Jiherbe/Maeva/README.md

# Maeva
Base Domotique
Sources des programmes utilisés dans le projet domotique Maeva : Arduino, PHP, Mysql, Javascript.
CAO : Eagle. AGL : Netbeans
