Jiherbe/Maeva/Version 1.00/Documents/TeleInfo EDF.odt

Documentation de l'interface Datalogger TéléInfo

Version

1.10

Auteur

Jean-Roger BLOUIN

Date de dernière mise à jour : dimanche 12 février 2012

Historique du document

Date | Auteur | Version | Sujet de la modification
12/02/2012 | Jean-Roger BLOUIN | 1.10 | Création

# Présentation Générale.

## Le Contexte

Suite à la mise en place de panneaux solaires photovoltaïques pour revente totale de la production d'électricité, deux compteurs électriques supplémentaires ont été posés par ERDF :

- un compteur dit « d'injection » comptabilise la production
- un compteur de « non consommation » contrôle la revente totale de la production.

La consommation quotidienne est mesurée par le compteur d'abonné. Le suivi de la production et de la consommation impose un relevé périodique des compteurs et nécessite pour ce faire l'ouverture des coffrets situés en limite de propriété, extérieur pour le compteur de consommation, intérieur pour les deux autres.

## Objectifs.

Afin d'enregistrer les données émises par les 3 compteurs EDF, il est nécessaire de mettre en place un système qui permette le relevé de ces informations sans obligation d'accès aux coffrets extérieurs. Ce système devra idéalement enregistrer en permanence les données recueillies et permettre leur consultation en direct.

## Contraintes.

Le système de recueil de l'information sur les compteurs doit être indépendant et isolé du réseau EDF.

Les compteur seront surveillés l'un après l'autre de façon cyclique selon une périodicité ajustable. La surveillance simultanée fera l'objet d'une étude ultérieure.

Le système mis en place doit répondre aux spécifications et contraintes suivantes :

- Ne pas mobiliser un PC en permanence (économie d'énergie).
- Être autonome.
- Être interrogé à distance.
- Être configuré localement.
- Être de taille réduite.
- Faire largement appel aux ressources existantes.

## La Solution.

Un système d'enregistrement périodique des données (datalogger) a été retenu. Ce système offre les options suivantes :

a. l'enregistrement sur PC,
b. l'enregistrement de manière autonome sur carte SD,
c. l'envoi des donnée sur réseau Ethernet.

Ce système est basé sur une carte ARDUINO® associée à une ou plusieurs mezzanines selon les besoins.

# La Réalisation.

## Hardware.

## Software.

# Annexes.

# Références.

Parmi les nombreuses études similaires accessibles sur Internet, les liens suivant renvoient à celles qui ont plus spécifiquement inspirés cette réalisation.

- Documentation de l'interface Datalogger TéléInfo

Page 1 sur 11
