Jiherbe/Maeva/Version 1.00/Documents/TeleInfo Maeva1.odt

# Présentation Générale.

## Le Contexte

Suite à la mise en place de panneaux solaires photovoltaïques pour revente totale de la production d'électricité, deux compteurs électriques supplémentaires ont été posés par ERDF :

- un compteur dit « d'injection » comptabilise la production
- un compteur de « non consommation » contrôle la revente totale de la production.

La consommation quotidienne est mesurée par le compteur d'abonné. Le suivi de la production et de la consommation impose un relevé périodique des compteurs et nécessite pour ce faire l'ouverture des coffrets situés en limite de propriété, extérieur pour le compteur de consommation, intérieur pour les deux autre.

## Objectifs.

Télé-surveiller les 3 compteurs EDF :

- soutirage : compteur d'abonné triphasé avec heures creuses ;
- production : appelé aussi « injection », mesure l'énergie PV produite, monophasé sans HC ;
- non consommation : monophasé sans HC, sert à contrôler la revente totale de la production PV.

## La liaison Téléinfo.

(Source: [GESTIONNAIRE D'ÉNERGIE (http://bernard.lefrancois.free.fr/) ])

Les compteurs électroniques EDF possèdent deux bornes de télé information à disposition du client. Sur celles-ci, il est possible d'y lire des données informatiques sur la consommation électrique.

L'utilisation de ces bornes est, à l'origine, surtout destinée aux gestionnaires d’énergie disponibles dans le commerce. Mais il est aussi possible d'exploiter ces données sur un PC.

Les informations sont émises cycliquement sous forme de messages composés d’une étiquette d’identification suivie généralement d’une valeur.

Le signal est modulé à 50 KHz : la présence de modulation correspondant à un 0 logique, l’absence à un 1 logique. Il est donc nécessaire de démoduler ce signal. A l'issue, on obtient une suite de caractères ASCII émise à 1200 bits/s, 7 bits/caractères, parité paire, 1 bit de stop.

Chaque information débute par le caractère LF (0Ah), suivie de l’étiquette, de la valeur associée et se termine par le caractère CR (0Dh).

## Contraintes.

Le système de recueil de l'information sur les compteurs doit être indépendant et isolé du réseau EDF.

Les compteur seront surveillés l'un après l'autre de façon cyclique selon une périodicité ajustable. La surveillance simultanée fera l'objet d'une étude ultérieure.

Le système mis en place doit répondre aux spécifications et contraintes suivantes :

- C1 : Ne pas mobiliser un PC en permanence (économie d'énergie).
- C2 : Être autonome.
- C3 : Être interrogé à distance.
- C4 : Être configuré localement.
- C5 : Être de taille réduite.
- C6 : Faire largement appel aux ressources existantes.

## Fonctions du Système.

Le système devra réaliser les 6 fonctions suivantes :

F1 : capture du signal ;

F2 : mise en forme du signal ;

F3 : choix du signal à enregistrer ;

F4 : traitement ;

F5 : horodatage ;

F6 : enregistrement ;

F7 : serveur Web.

## Analyse des Solutions

Après étude des systèmes divers et variés présentés sur le Web, un système d'enregistrement périodique des données, ou datalogger a été retenu. Ce système peut se décliner selon plusieurs options :

1. enregistrement sur PC,
2. enregistrement de manière autonome sur carte SD,
3. mise à disposition des donnée sur réseau Ethernet.

Ces options pourraient par ailleurs être offertes simultanément., les deux premières pouvant être combinées avec la troisième.

- : Enregistrement sur PC : solution la plus simple, ne nécessitant aucun développement matériel ou logiciel particulier. Un PC, raccordé via le port série au compteur, permet l'enregistrement direct des trames de mesure avec un terminal série. Cette solution ne répond pas aux contraintes préalablement fixée (C1 et C5).

- : Enregistrement sur carte SD : cette solution implique la mise en place d'un système d'enregistrement (commercial ou local) mais répond à la plupart des contraintes sauf C3.

- : Réseau Web : implique la mise en place d'un serveur Web et ne permet pas, en tant que telle, l'enregistrement des données. Il faut impérativement lui adjoindre un système d'enregistrement.

La solution optimale qui ressort des ces réflexions est un système autonome muni d'un lecteur-enregistreur de carte et d'un mini serveur WEB.

## Solution retenue.

Pour mettre en œuvre la solution optimale présentée ci-dessus, de nombreux matériels bon marché sont disponibles dans le commerce.

Pour une mise en place plus rapide, il a été décidé de différer la solution Web.

Parmi tous les systèmes autonomes disponibles, le choix s'est porté sur une carte ARDUINO® UNO en raison de son coût raisonnable, de sa disponibilité et des nombreuses réalisations faites sur cette plateforme. D'autre part, tous le système ARDUINO (hard et soft) est Open Source et multi-plateformes (Windows, Mac OS x et Linux).

Compte tenu de la disponibilité de mezzanines dédiées à cet usage, la fonction enregistrement ne sera pas développée localement mais acquise. Parmi les différents modèles commerciaux (microSD Shield de Sparkfun, Data Logging Shield d'Adafruit, Shield Mémoire de Snootlab) seuls les deux derniers intègrent d'origine la fonction horodatage. Compte tenu de son prix, le choix s'est porté sur le kit du shield mémoire de Snootlab qui comporte en outre une zone de prototypage permettant l’implantation des fonctions mise en forme et commutation.

L'enregistrement du compteur 3 (non consommation) a été abandonnée en raison de son peu d'intérêt.

Page 0 sur 5
