Jiherbe/Maeva/(commit log)

2017-08-18 Datalogger TéélInfo EDF sur 2 compteurs
    Source original issue de la v0.3b de Cartelec.
    [Enreg_TeleInfo.ods, Memoire-1.0.brd, Memoire-1.0.sch, arduino_Uno_Rev3-02-TH.brd, arduino_Uno_Rev3-02-TH.sch]
2017-09-28 TéléInfo EDF à 2 compteurs.
    Datalogger sur Arduino pour compteur de production et compteur de consomation, enregistrement sur carte SD.
